bit-trade-one/ADCRKTR1-KTR-1/README.md

#### [GitHubの使い方はこちらの記事をご確認ください。](https://bit-trade-one.co.jp/h2gh/)
# ADCRKTR1-KTR-1



Arduino制御入門用ロボットキット 「KTR-1」のサポートページです。  

#### ※PC接続時はバッテリーパワーをオフにしてください

<!--
改行する場合、文末に半角スペース2個を置く

リンクの貼り方
[リンクになる文章](URL)
exp.
[Google](https://www.google.co.jp/)

画像の貼り方
![画像が読めない時に表示されるテキスト](画像のURL)
exp.
![bit-trade-one](https://bit-trade-one.co.jp/wp/wp-content/uploads/tcd-w/logo.png)
※先頭の"!"を忘れないこと

見出しの付け方

# 見出し1

## 見出し1-1

###　見出し1-2

# 見出し2

"#"を増やすと下位の見出しになる

-->

<!--
以下のURL内の"-ADXXXXX-Template"をリポジトリ名/ファイル名に変更 

製品によって無い情報(ライブラリへのリンクなど)は削除すること

ソフトの使い方、ライブラリの使い方などがWordなどである場合は、
各情報フォルダにMarkdown形式に起こし"Readme.md"という名前で保存すること
-->
# [WEB教材](https://sites.google.com/view/ktr-1-webstudy/%E3%83%88%E3%83%83%E3%83%97)

### [組み立て方](https://sites.google.com/view/ktr-1-webstudy/0-%E7%B5%84%E3%81%BF%E7%AB%8B%E3%81%A6?authuser=0)

## [Q&A](https://github.com/bit-trade-one/ADCRKTR1-KTR-1/blob/master/FAQ.md)

### [製品HP](https://bit-trade-one.co.jp/adcrktr1/) 

### [Arduinoスケッチ](https://github.com/bit-trade-one/ADCRKTR1-KTR-1/tree/master/Firmware)

### [回路図](https://github.com/bit-trade-one/ADCRKTR1-KTR-1/blob/master/Schematics/KTR-1%E5%9B%9E%E8%B7%AF%E5%9B%B3V1.11.pdf)

### [寸法図・3Dデータ](https://github.com/bit-trade-one/ADCRKTR1-KTR-1/tree/master/Dimensions)

### [基板図](https://github.com/bit-trade-one/ADCRKTR1-KTR-1/blob/master/Schematics/KTR-1%E5%9F%BA%E6%9D%BF%E5%9B%B3V1.1.pdf)

### [付属紙組み立て図](https://github.com/bit-trade-one/ADCRKTR1-KTR-1/blob/master/Assembly/%E7%B5%84%E3%81%BF%E7%AB%8B%E3%81%A6%E5%9B%B3.png)

<!--
## 作例

[BTO公式]()  
[Twitter作例1]()  
[Twitter作例2]()  
[ブログ作例1]()  
[ブログ作例1]()  

## 雑誌掲載情報

[ラズパイマガジンXX年Y月号]()  
[Pc Watch]()
-->
## 製品仕様
【搭載マイコン】Pro micro互換_ATmega32U4 5V/16MHz  
【搭載モータドライバ】DRV8832互換×2  
【外部インターフェース】USB MicroB  
【周辺機能】超音波センサー(測定距離2-400cm)、圧電スピーカー、LEDx2、半固定抵抗、タクトスイッチx2  
【電源】単三アルカリ電池x3 （電池は付属していません）  
【プログラミング環境】Arduino IDE(対応OS Windows,MAC OS,他)  
【駆動部】DC3V_30RPMモータx2  
【本体重量】約105g  
【本体サイズ】約W84×H45×D114mm  
【内容物】制御基板×1,ボールキャスタ固定基板×1  
&ensp;M2*17mmスペーサx2、M2*12mmスペーサx4、M2*5ネジ×16  
&ensp;タイヤ及びギヤボックスx2、アクリルガード、USB通信ケーブル   
【別途必要物】プラスドライバー 、マイナスドライバー  
【使用温度】 0 ～ 40℃（結露なきこと）
