bit-trade-one/ADCRKTR1-KTR-1/Dimensions/KTR-1アクリル3D.step

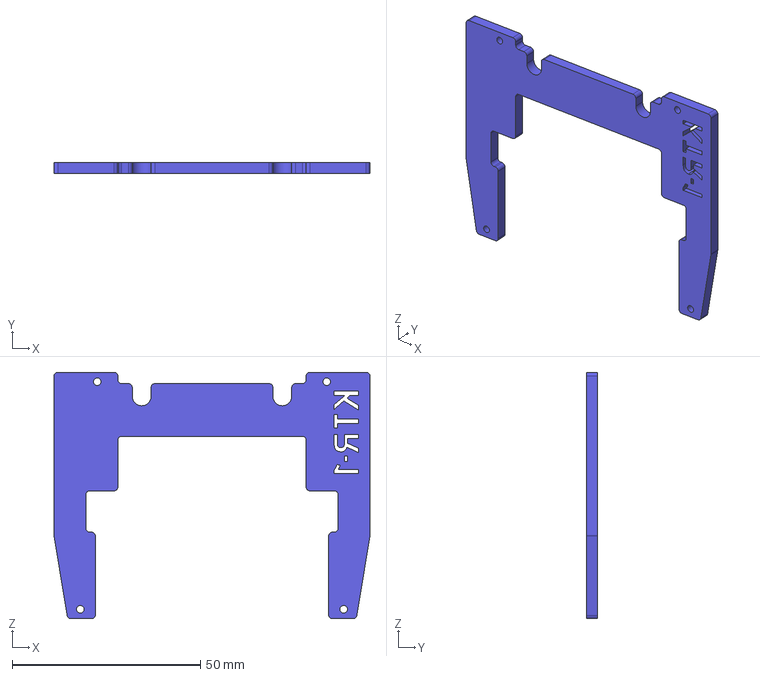
[picture p1: CAD file, 2022-01-24]
Dimensions/KTR-1アクリル3D.step
84.0 x 3.00 x 65.5 mm
