bit-trade-one/ADCRKTR1-KTR-1/(list of files, cad)

Other CAD files:
Dimensions/KTR-1アクリル3D.stl
