bit-trade-one/ADCRKTR1-KTR-1/Schematics/KTR-1回路図V1.11.pdf

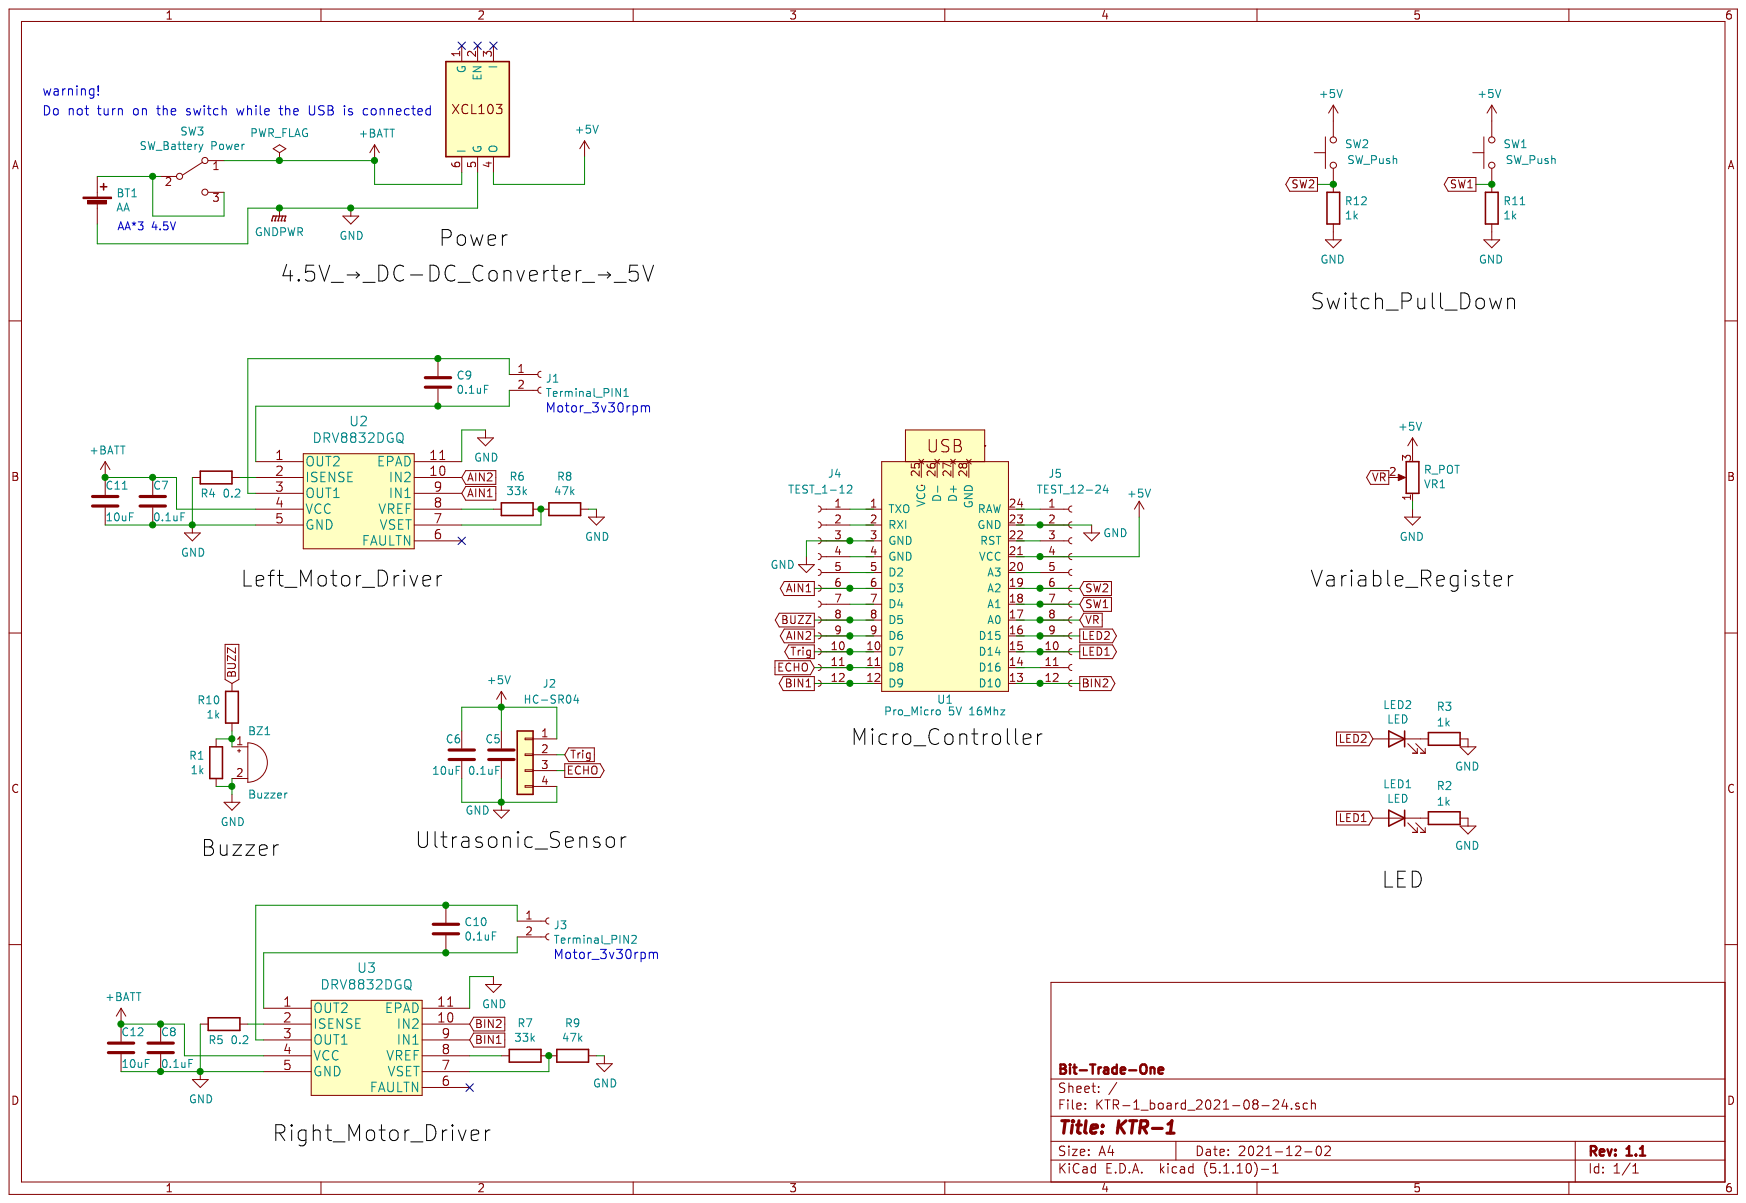
[picture p2: page 1]
