bit-trade-one/ADCRKTR1-KTR-1/Dimensions/KTR-1その他部品寸法 v4.pdf

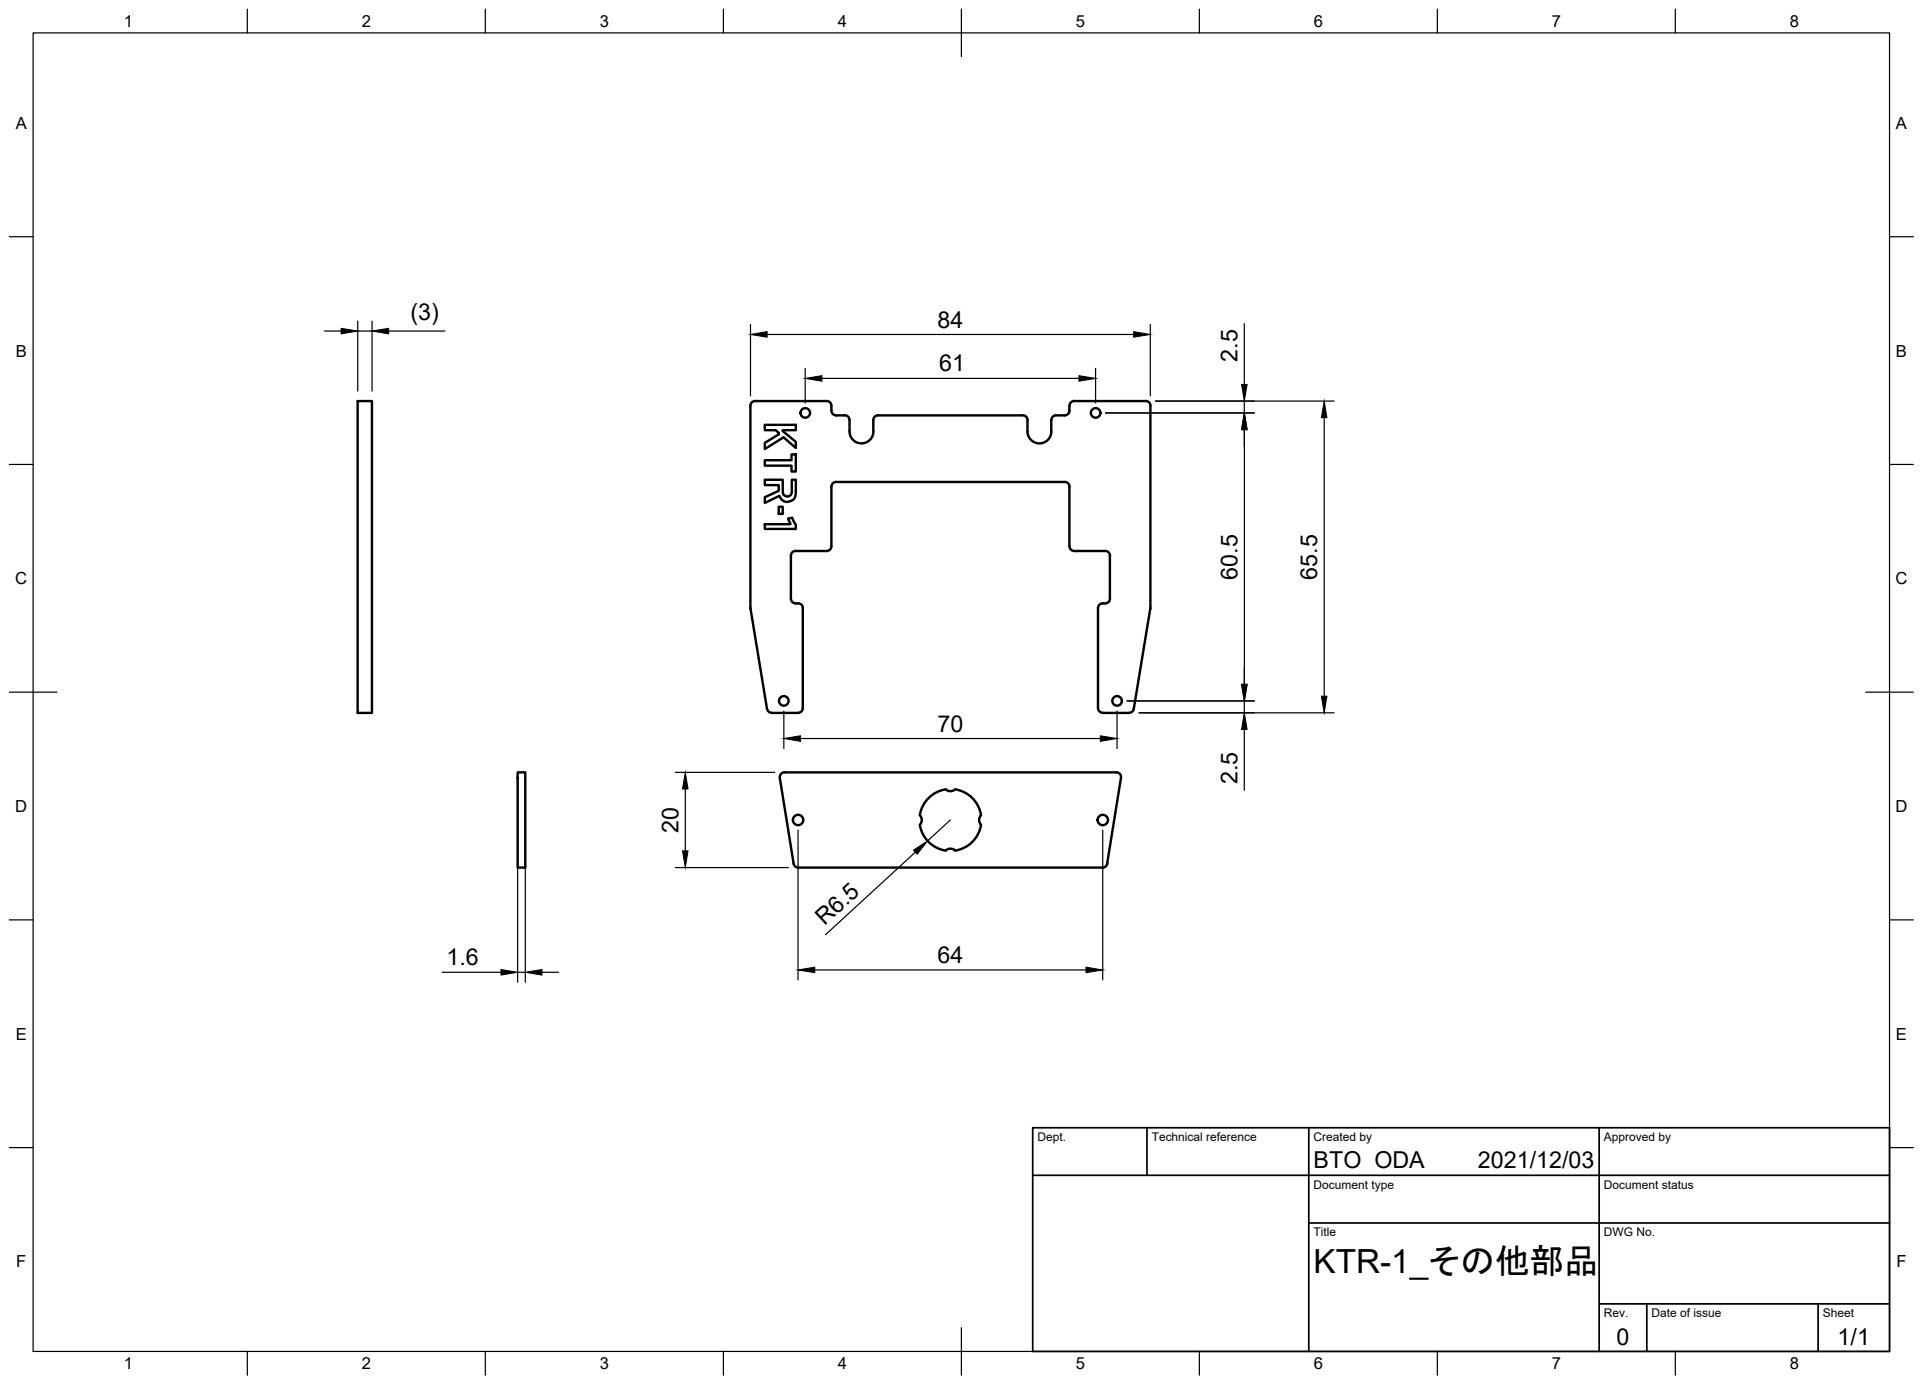
[picture p3: page 1]
Title; DWG No.; Rev.; Date of issue; Sheet

Dept. | Technical reference | Created by BTO ODA 2021/12/03 | Approved by

Document type | Document status
