bit-trade-one/ADCRKTR1-KTR-1/Schematics/KTR-1基板図V1.1.pdf

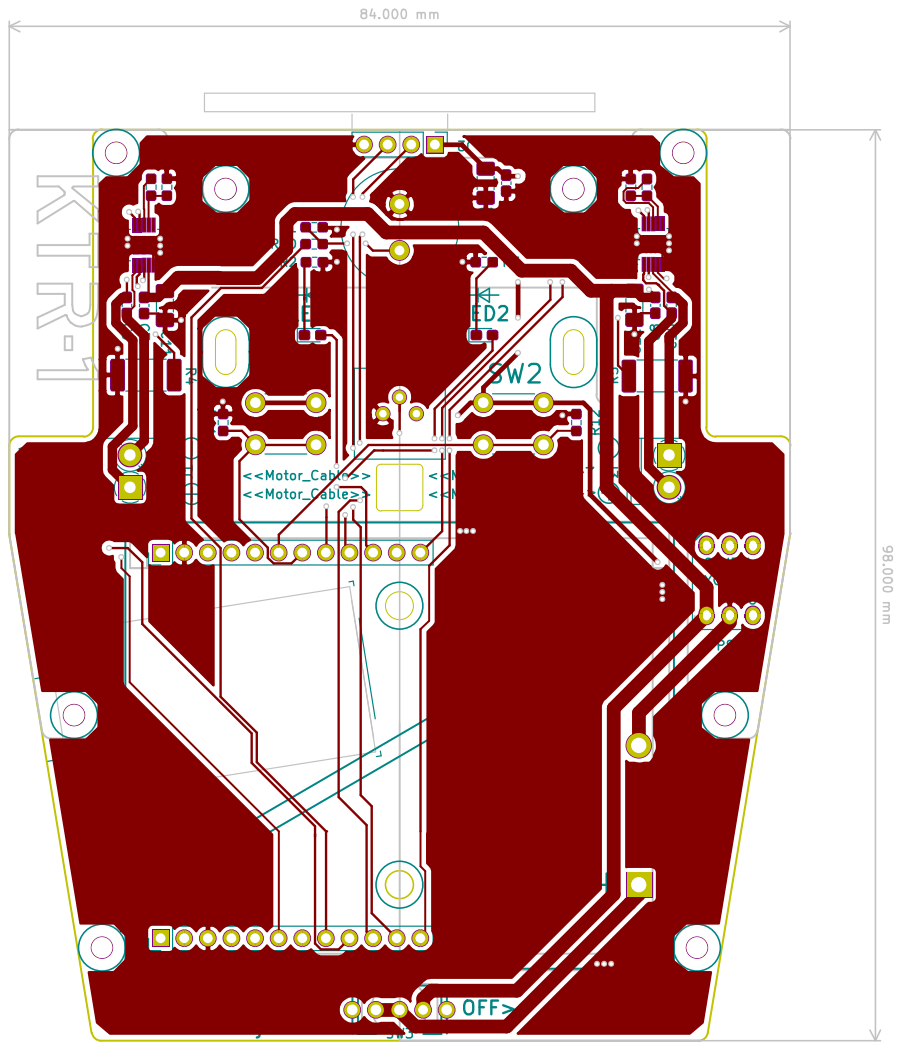
[picture p4: page 1]

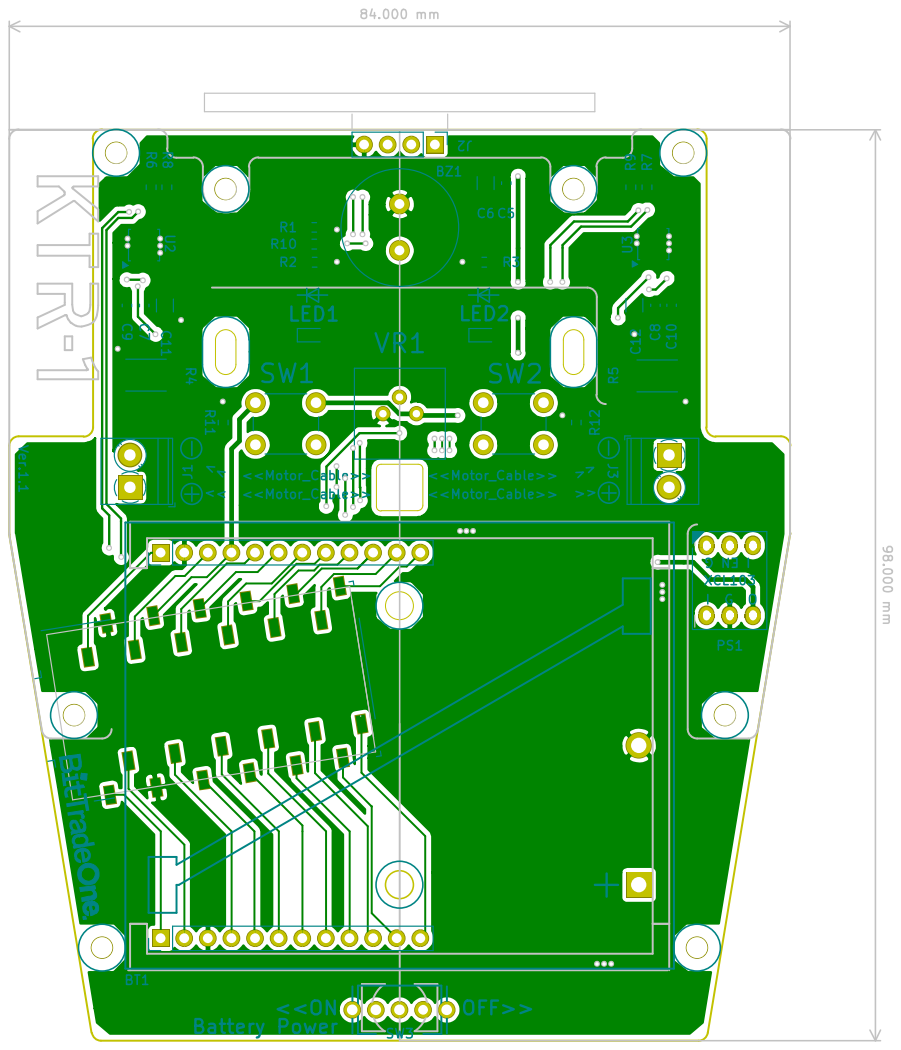
[picture p5: page 2]
