bit-trade-one/ADCRKTR1-KTR-1/Assembly/組み立て図.png

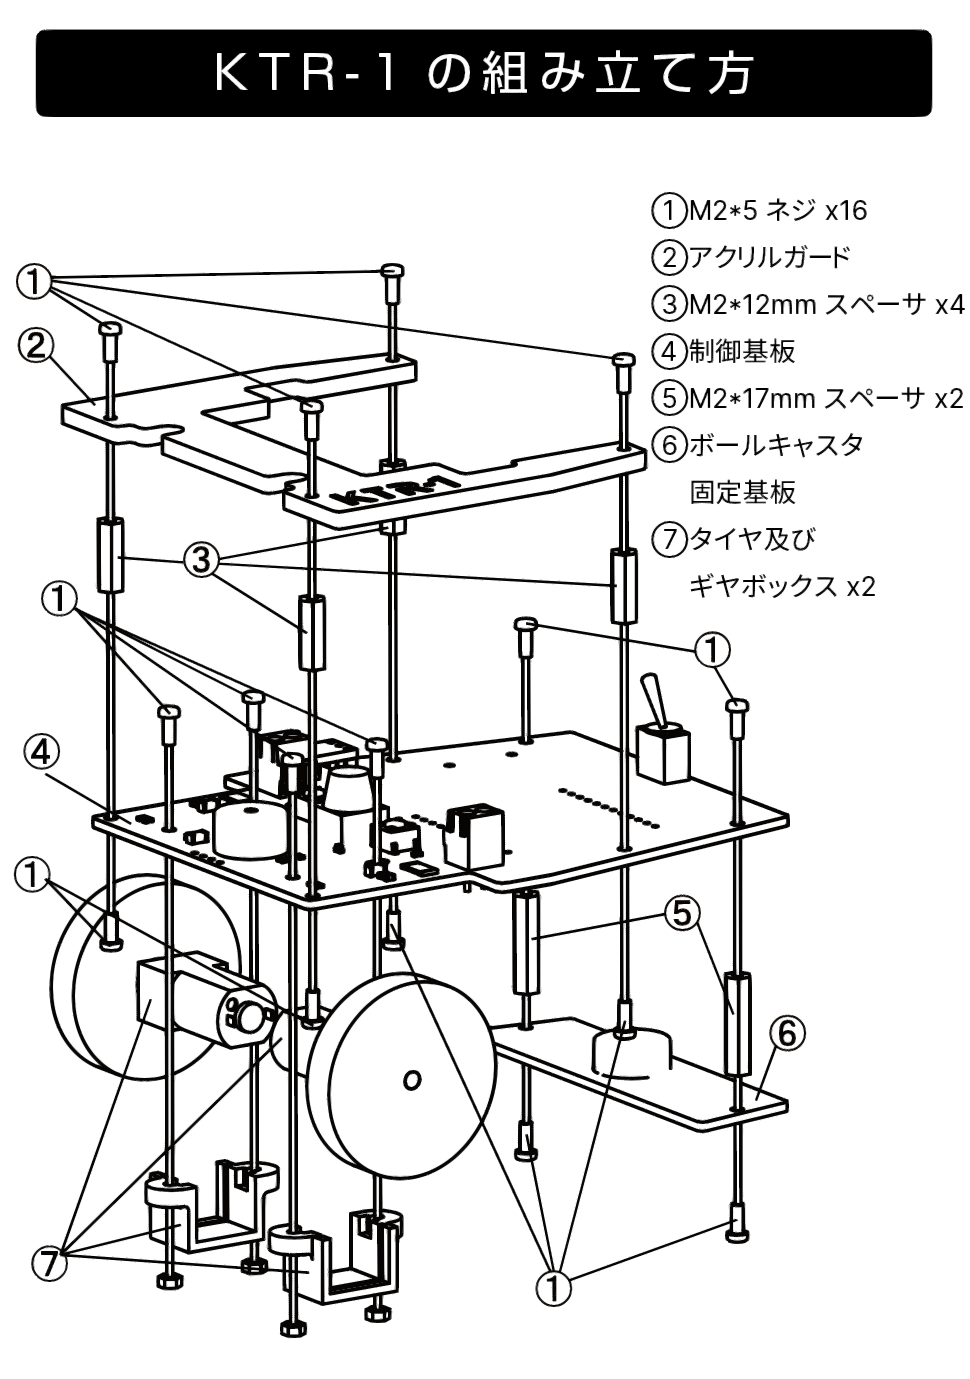
Assembly/組み立て図.png
